geekman7473/enee408i-s2020-team2/ALAN_Carrier_board/carrier_board.brd

## EAGLE design ALAN_Carrier_board/carrier_board.brd (2020-02-28)

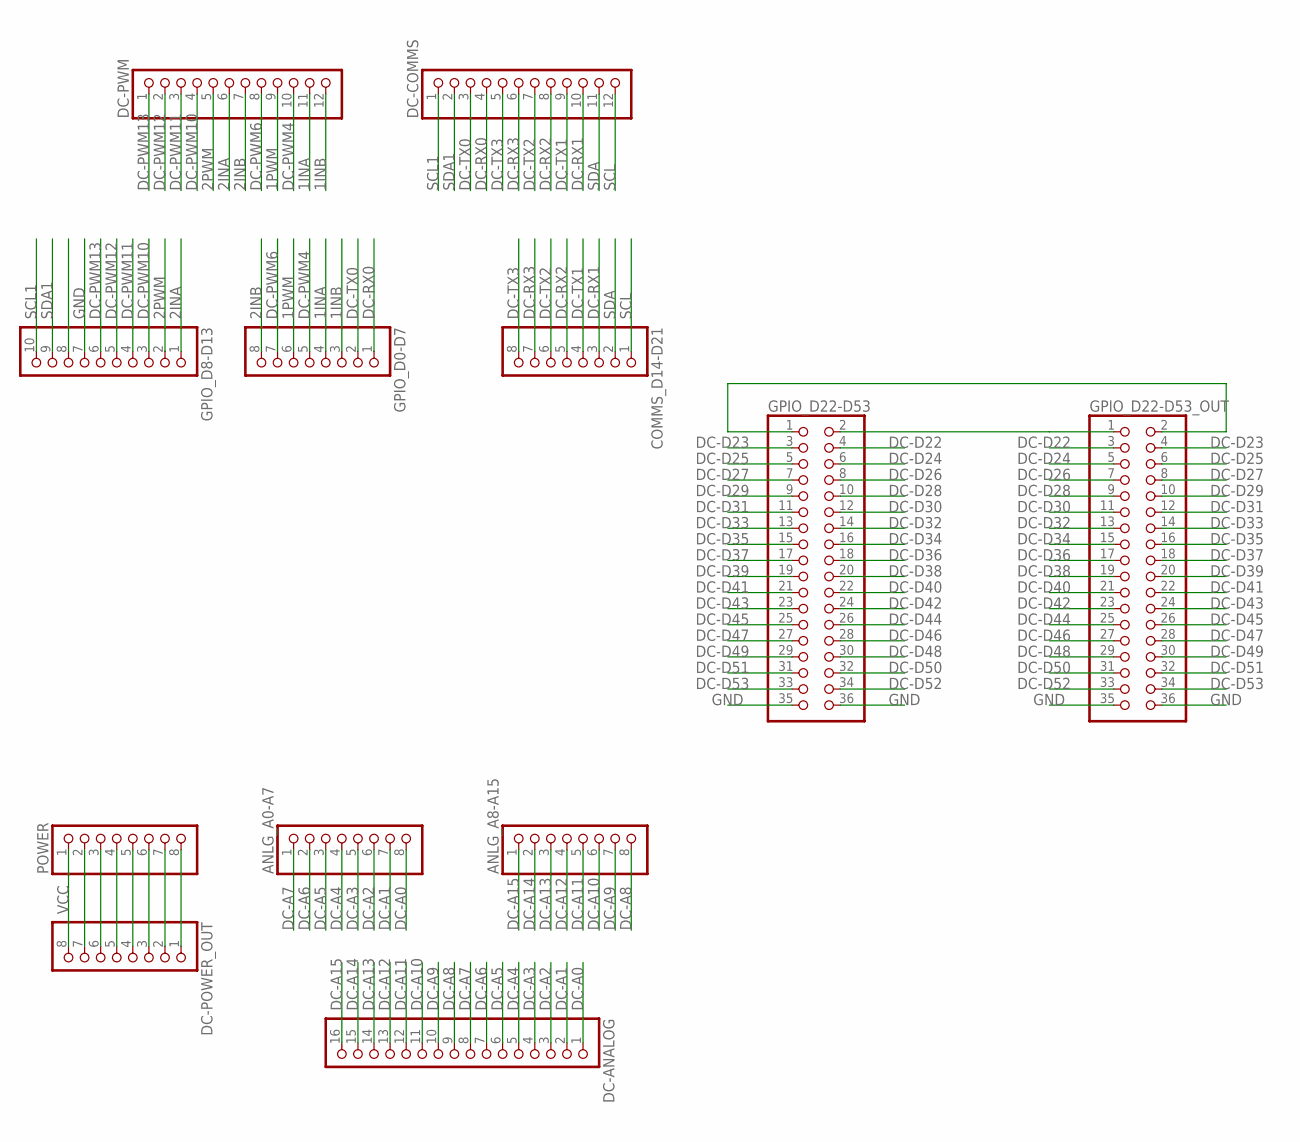
[picture p1: schematic carrier_board.sch, sheet 1, Main Board]

Parts:
ANLG_A0-A7, ANLG_A8-A15: PINHD-1X8; 1X08
COMMS_D14-D21: PINHD-1X8; 1X08
DC-ANALOG: PINHD-1X16; 1X16
DC-COMMS: PINHD-1X12; 1X12
DC-POWER_OUT: PINHD-1X8; 1X08
DC-PWM: PINHD-1X12; 1X12
GPIO_D0-D7: PINHD-1X8; 1X08
GPIO_D8-D13: PINHD-1X10; 1X10
GPIO_D22-D53, GPIO_D22-D53_OUT: PINHD-2X18; 2X18
POWER: PINHD-1X8; 1X08

Connections:
1INA: DC-PWM.11, GPIO_D0-D7.4; also elsewhere on the board
1INB: DC-PWM.12, GPIO_D0-D7.3; also elsewhere on the board
1PWM: DC-PWM.9, GPIO_D0-D7.6; also elsewhere on the board
2INA: DC-PWM.6, GPIO_D8-D13.1; also elsewhere on the board
2INB: DC-PWM.7, GPIO_D0-D7.8; also elsewhere on the board
2PWM: DC-PWM.5, GPIO_D8-D13.2; also elsewhere on the board
DC-A0: ANLG_A0-A7.8, DC-ANALOG.1
DC-A1: ANLG_A0-A7.7, DC-ANALOG.2
DC-A2: ANLG_A0-A7.6, DC-ANALOG.3
DC-A3: ANLG_A0-A7.5, DC-ANALOG.4
DC-A4: ANLG_A0-A7.4, DC-ANALOG.5
DC-A5: ANLG_A0-A7.3, DC-ANALOG.6
DC-A6: ANLG_A0-A7.2, DC-ANALOG.7
DC-A7: ANLG_A0-A7.1, DC-ANALOG.8
DC-A8: ANLG_A8-A15.8, DC-ANALOG.9
DC-A9: ANLG_A8-A15.7, DC-ANALOG.10
DC-A10: ANLG_A8-A15.6, DC-ANALOG.11
DC-A11: ANLG_A8-A15.5, DC-ANALOG.12
DC-A12: ANLG_A8-A15.4, DC-ANALOG.13
DC-A13: ANLG_A8-A15.3, DC-ANALOG.14
DC-A14: ANLG_A8-A15.2, DC-ANALOG.15
DC-A15: ANLG_A8-A15.1, DC-ANALOG.16
DC-D22: GPIO_D22-D53.4, GPIO_D22-D53_OUT.3
DC-D23: GPIO_D22-D53.3, GPIO_D22-D53_OUT.4
DC-D24: GPIO_D22-D53.6, GPIO_D22-D53_OUT.5
DC-D25: GPIO_D22-D53.5, GPIO_D22-D53_OUT.6
DC-D26: GPIO_D22-D53.8, GPIO_D22-D53_OUT.7
DC-D27: GPIO_D22-D53.7, GPIO_D22-D53_OUT.8
DC-D28: GPIO_D22-D53.10, GPIO_D22-D53_OUT.9
DC-D29: GPIO_D22-D53.9, GPIO_D22-D53_OUT.10
DC-D30: GPIO_D22-D53.12, GPIO_D22-D53_OUT.11
DC-D31: GPIO_D22-D53.11, GPIO_D22-D53_OUT.12
DC-D32: GPIO_D22-D53.14, GPIO_D22-D53_OUT.13
DC-D33: GPIO_D22-D53.13, GPIO_D22-D53_OUT.14
DC-D34: GPIO_D22-D53.16, GPIO_D22-D53_OUT.15
DC-D35: GPIO_D22-D53.15, GPIO_D22-D53_OUT.16
DC-D36: GPIO_D22-D53.18, GPIO_D22-D53_OUT.17
DC-D37: GPIO_D22-D53.17, GPIO_D22-D53_OUT.18
DC-D38: GPIO_D22-D53.20, GPIO_D22-D53_OUT.19
DC-D39: GPIO_D22-D53.19, GPIO_D22-D53_OUT.20
DC-D40: GPIO_D22-D53.22, GPIO_D22-D53_OUT.21
DC-D41: GPIO_D22-D53.21, GPIO_D22-D53_OUT.22
DC-D42: GPIO_D22-D53.24, GPIO_D22-D53_OUT.23
DC-D43: GPIO_D22-D53.23, GPIO_D22-D53_OUT.24
DC-D44: GPIO_D22-D53.26, GPIO_D22-D53_OUT.25
DC-D45: GPIO_D22-D53.25, GPIO_D22-D53_OUT.26
DC-D46: GPIO_D22-D53.28, GPIO_D22-D53_OUT.27
DC-D47: GPIO_D22-D53.27, GPIO_D22-D53_OUT.28
DC-D48: GPIO_D22-D53.30, GPIO_D22-D53_OUT.29
DC-D49: GPIO_D22-D53.29, GPIO_D22-D53_OUT.30
DC-D50: GPIO_D22-D53.32, GPIO_D22-D53_OUT.31
DC-D51: GPIO_D22-D53.31, GPIO_D22-D53_OUT.32
DC-D52: GPIO_D22-D53.34, GPIO_D22-D53_OUT.33
DC-D53: GPIO_D22-D53.33, GPIO_D22-D53_OUT.34
DC-PWM4: DC-PWM.10, GPIO_D0-D7.5
DC-PWM6: DC-PWM.8, GPIO_D0-D7.7
DC-PWM10: DC-PWM.4, GPIO_D8-D13.3
DC-PWM11: DC-PWM.3, GPIO_D8-D13.4
DC-PWM12: DC-PWM.2, GPIO_D8-D13.5
DC-PWM13: DC-PWM.1, GPIO_D8-D13.6
DC-RX0: DC-COMMS.4, GPIO_D0-D7.1
DC-RX1: COMMS_D14-D21.3, DC-COMMS.10
DC-RX2: COMMS_D14-D21.5, DC-COMMS.8
DC-RX3: COMMS_D14-D21.7, DC-COMMS.6
DC-TX0: DC-COMMS.3, GPIO_D0-D7.2
DC-TX1: COMMS_D14-D21.4, DC-COMMS.9
DC-TX2: COMMS_D14-D21.6, DC-COMMS.7
DC-TX3: COMMS_D14-D21.8, DC-COMMS.5
GND: GPIO_D8-D13.7, GPIO_D22-D53.35, GPIO_D22-D53.36, GPIO_D22-D53_OUT.35, GPIO_D22-D53_OUT.36; also elsewhere on the board
unnamed: GPIO_D22-D53.1, GPIO_D22-D53_OUT.2
unnamed: GPIO_D22-D53.2, GPIO_D22-D53_OUT.1
unnamed: DC-POWER_OUT.1, POWER.8
unnamed: DC-POWER_OUT.2, POWER.7
unnamed: DC-POWER_OUT.3, POWER.6
unnamed: DC-POWER_OUT.4, POWER.5
unnamed: DC-POWER_OUT.5, POWER.4
unnamed: DC-POWER_OUT.6, POWER.3
unnamed: DC-POWER_OUT.7, POWER.2
SCL: COMMS_D14-D21.1, DC-COMMS.12; also elsewhere on the board
SCL1: DC-COMMS.1, GPIO_D8-D13.10
SDA: COMMS_D14-D21.2, DC-COMMS.11; also elsewhere on the board
SDA1: DC-COMMS.2, GPIO_D8-D13.9
VCC: DC-POWER_OUT.8, POWER.1; also elsewhere on the board

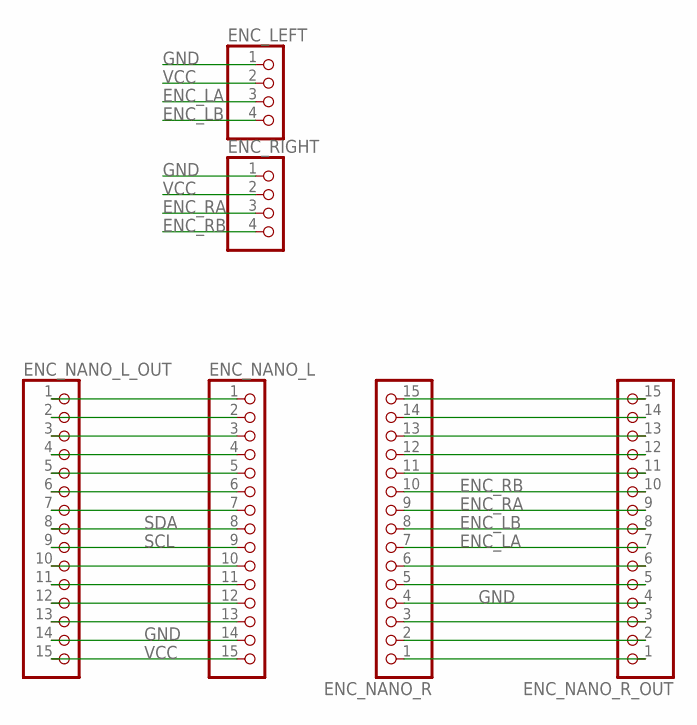
[picture p2: schematic carrier_board.sch, sheet 2, Encoder Nano]

Parts:
ENC_LEFT: PINHD-1X4/90; 1X04/90
ENC_NANO_L: PINHD-1X15; 1X15
ENC_NANO_L_OUT: PINHD-1X15; 1X15
ENC_NANO_R: PINHD-1X15; 1X15
ENC_NANO_R_OUT: PINHD-1X15; 1X15
ENC_RIGHT: PINHD-1X4/90; 1X04/90

Connections:
ENC_LA: ENC_LEFT.3, ENC_NANO_R.7, ENC_NANO_R_OUT.7
ENC_LB: ENC_LEFT.4, ENC_NANO_R.8, ENC_NANO_R_OUT.8
ENC_RA: ENC_NANO_R.9, ENC_NANO_R_OUT.9, ENC_RIGHT.3
ENC_RB: ENC_NANO_R.10, ENC_NANO_R_OUT.10, ENC_RIGHT.4
GND: ENC_LEFT.1, ENC_NANO_L.14, ENC_NANO_L_OUT.14, ENC_NANO_R.4, ENC_NANO_R_OUT.4, ENC_RIGHT.1; also elsewhere on the board
unnamed: ENC_NANO_L.13, ENC_NANO_L_OUT.13
unnamed: ENC_NANO_L.12, ENC_NANO_L_OUT.12
unnamed: ENC_NANO_L.11, ENC_NANO_L_OUT.11
unnamed: ENC_NANO_L.10, ENC_NANO_L_OUT.10
unnamed: ENC_NANO_L.7, ENC_NANO_L_OUT.7
unnamed: ENC_NANO_L.6, ENC_NANO_L_OUT.6
unnamed: ENC_NANO_L.5, ENC_NANO_L_OUT.5
unnamed: ENC_NANO_L.4, ENC_NANO_L_OUT.4
unnamed: ENC_NANO_L.3, ENC_NANO_L_OUT.3
unnamed: ENC_NANO_L.2, ENC_NANO_L_OUT.2
unnamed: ENC_NANO_L.1, ENC_NANO_L_OUT.1
unnamed: ENC_NANO_R.15, ENC_NANO_R_OUT.15
unnamed: ENC_NANO_R.14, ENC_NANO_R_OUT.14
unnamed: ENC_NANO_R.13, ENC_NANO_R_OUT.13
unnamed: ENC_NANO_R.12, ENC_NANO_R_OUT.12
unnamed: ENC_NANO_R.11, ENC_NANO_R_OUT.11
unnamed: ENC_NANO_R.6, ENC_NANO_R_OUT.6
unnamed: ENC_NANO_R.5, ENC_NANO_R_OUT.5
unnamed: ENC_NANO_R.3, ENC_NANO_R_OUT.3
unnamed: ENC_NANO_R.2, ENC_NANO_R_OUT.2
unnamed: ENC_NANO_R.1, ENC_NANO_R_OUT.1
SCL: ENC_NANO_L.9, ENC_NANO_L_OUT.9; also elsewhere on the board
SDA: ENC_NANO_L.8, ENC_NANO_L_OUT.8; also elsewhere on the board
VCC: ENC_LEFT.2, ENC_NANO_L.15, ENC_NANO_L_OUT.15, ENC_RIGHT.2; also elsewhere on the board

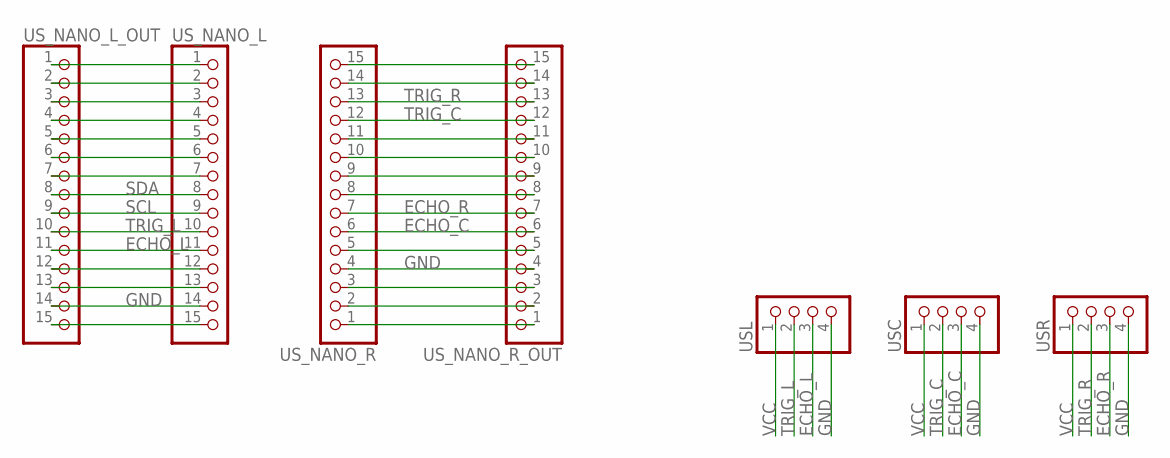
[picture p3: schematic carrier_board.sch, sheet 3, Ultrasonic Nano]

Parts:
USC: PINHD-1X4/90; 1X04/90
USL: PINHD-1X4/90; 1X04/90
USR: PINHD-1X4/90; 1X04/90
US_NANO_L: PINHD-1X15; 1X15
US_NANO_L_OUT: PINHD-1X15; 1X15
US_NANO_R: PINHD-1X15; 1X15
US_NANO_R_OUT: PINHD-1X15; 1X15

Connections:
ECHO_C: USC.3, US_NANO_R.6, US_NANO_R_OUT.6
ECHO_L: USL.3, US_NANO_L.11, US_NANO_L_OUT.11
ECHO_R: USR.3, US_NANO_R.7, US_NANO_R_OUT.7
GND: USC.4, USL.4, USR.4, US_NANO_L.14, US_NANO_L_OUT.14, US_NANO_R.4, US_NANO_R_OUT.4; also elsewhere on the board
unnamed: US_NANO_R.15, US_NANO_R_OUT.15
unnamed: US_NANO_R.14, US_NANO_R_OUT.14
unnamed: US_NANO_R.11, US_NANO_R_OUT.11
unnamed: US_NANO_R.10, US_NANO_R_OUT.10
unnamed: US_NANO_R.9, US_NANO_R_OUT.9
unnamed: US_NANO_R.8, US_NANO_R_OUT.8
unnamed: US_NANO_R.5, US_NANO_R_OUT.5
unnamed: US_NANO_R.3, US_NANO_R_OUT.3
unnamed: US_NANO_R.2, US_NANO_R_OUT.2
unnamed: US_NANO_R.1, US_NANO_R_OUT.1
unnamed: US_NANO_L.1, US_NANO_L_OUT.1
unnamed: US_NANO_L.2, US_NANO_L_OUT.2
unnamed: US_NANO_L.3, US_NANO_L_OUT.3
unnamed: US_NANO_L.4, US_NANO_L_OUT.4
unnamed: US_NANO_L.5, US_NANO_L_OUT.5
unnamed: US_NANO_L.6, US_NANO_L_OUT.6
unnamed: US_NANO_L.7, US_NANO_L_OUT.7
unnamed: US_NANO_L.12, US_NANO_L_OUT.12
unnamed: US_NANO_L.13, US_NANO_L_OUT.13
SCL: US_NANO_L.9, US_NANO_L_OUT.9; also elsewhere on the board
SDA: US_NANO_L.8, US_NANO_L_OUT.8; also elsewhere on the board
TRIG_C: USC.2, US_NANO_R.12, US_NANO_R_OUT.12
TRIG_L: USL.2, US_NANO_L.10, US_NANO_L_OUT.10
TRIG_R: USR.2, US_NANO_R.13, US_NANO_R_OUT.13
VCC: USC.1, USL.1, USR.1; also elsewhere on the board
VCC1: US_NANO_L.15, US_NANO_L_OUT.15

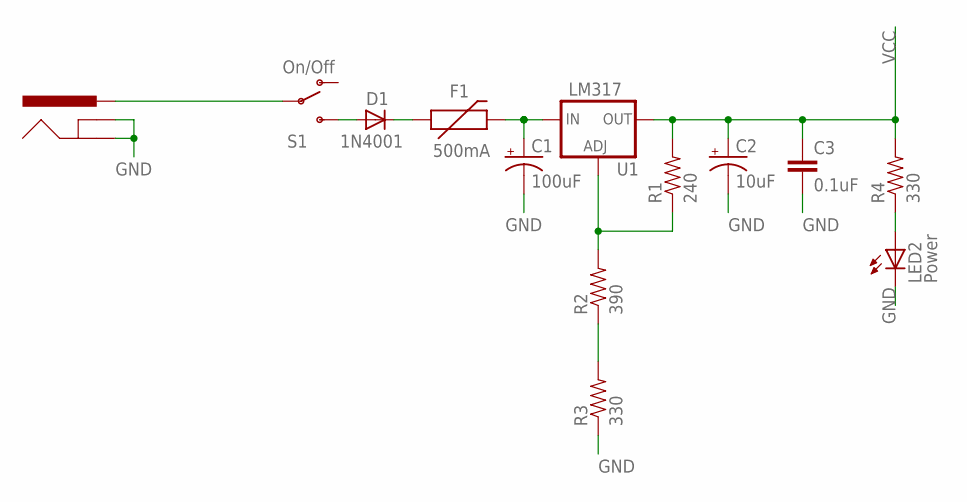
[picture p4: schematic carrier_board.sch, sheet 4, 5v Power board TODO: Remove 3.3 switch]

Parts:
C1: 100uF; CPOL-RADIAL-100UF-25V
C2: 10uF; CPOL-RADIAL-10UF-25V
C3: 0.1uF; CAP-PTH-SMALL2
D1: 1N4001; DIODE-0.4
F1: 500mA; PTC
J1: POWER_JACKPTH; POWER_JACK_PTH
LED2: Power; LED5MM
R1: 240; AXIAL-0.3
R2: 390; AXIAL-0.3
R3, R4: 330; AXIAL-0.3
S1: On/Off; SWITCH-SPST
U1: LM317; TO220-ADJ

Connections:
GND: C1.2 (-), C2.2 (-), C3.2, J1.GND, J1.GNDBREAK, LED2.K (C), R3.P$1 (1); also elsewhere on the board
unnamed: D1.C, F1.P$1 (1)
unnamed: D1.A, S1.3 (S)
unnamed: J1.PWR, S1.2
unnamed: R2.P$1 (1), R3.P$2 (2)
unnamed: R1.P$1 (1), R2.P$2 (2), U1.ADJ
unnamed: LED2.A, R4.P$1 (1)
RAW: C1.1 (+), F1.P$2 (2), U1.IN
VCC: C2.1 (+), C3.1, R1.P$2 (2), R4.P$2 (2), U1.OUT; also elsewhere on the board

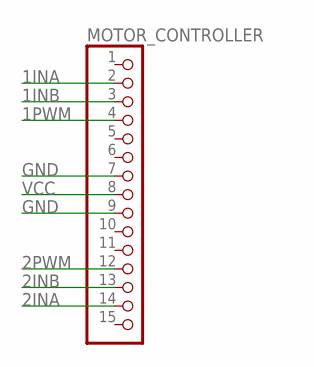
[picture p5: schematic carrier_board.sch, sheet 5, Motors/Motor Controllers]

Parts:
MOTOR_CONTROLLER: PINHD-1X15; 1X15

Connections:
1INA: MOTOR_CONTROLLER.2; also elsewhere on the board
1INB: MOTOR_CONTROLLER.3; also elsewhere on the board
1PWM: MOTOR_CONTROLLER.4; also elsewhere on the board
2INA: MOTOR_CONTROLLER.14; also elsewhere on the board
2INB: MOTOR_CONTROLLER.13; also elsewhere on the board
2PWM: MOTOR_CONTROLLER.12; also elsewhere on the board
GND: MOTOR_CONTROLLER.7, MOTOR_CONTROLLER.9; also elsewhere on the board
VCC: MOTOR_CONTROLLER.8; also elsewhere on the board

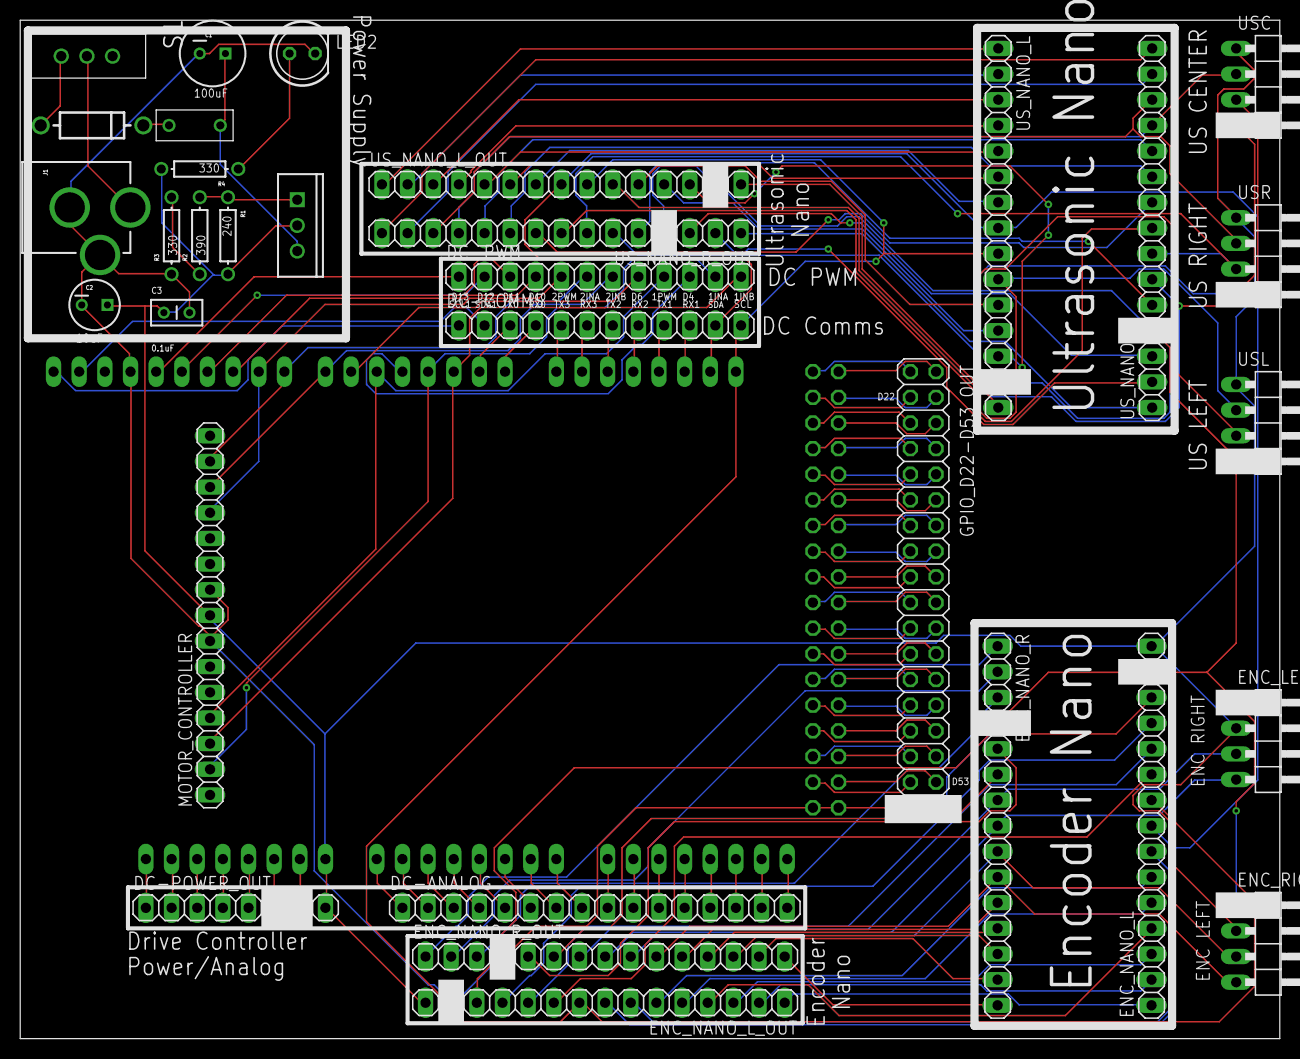
[picture p6: board carrier_board.brd from above]

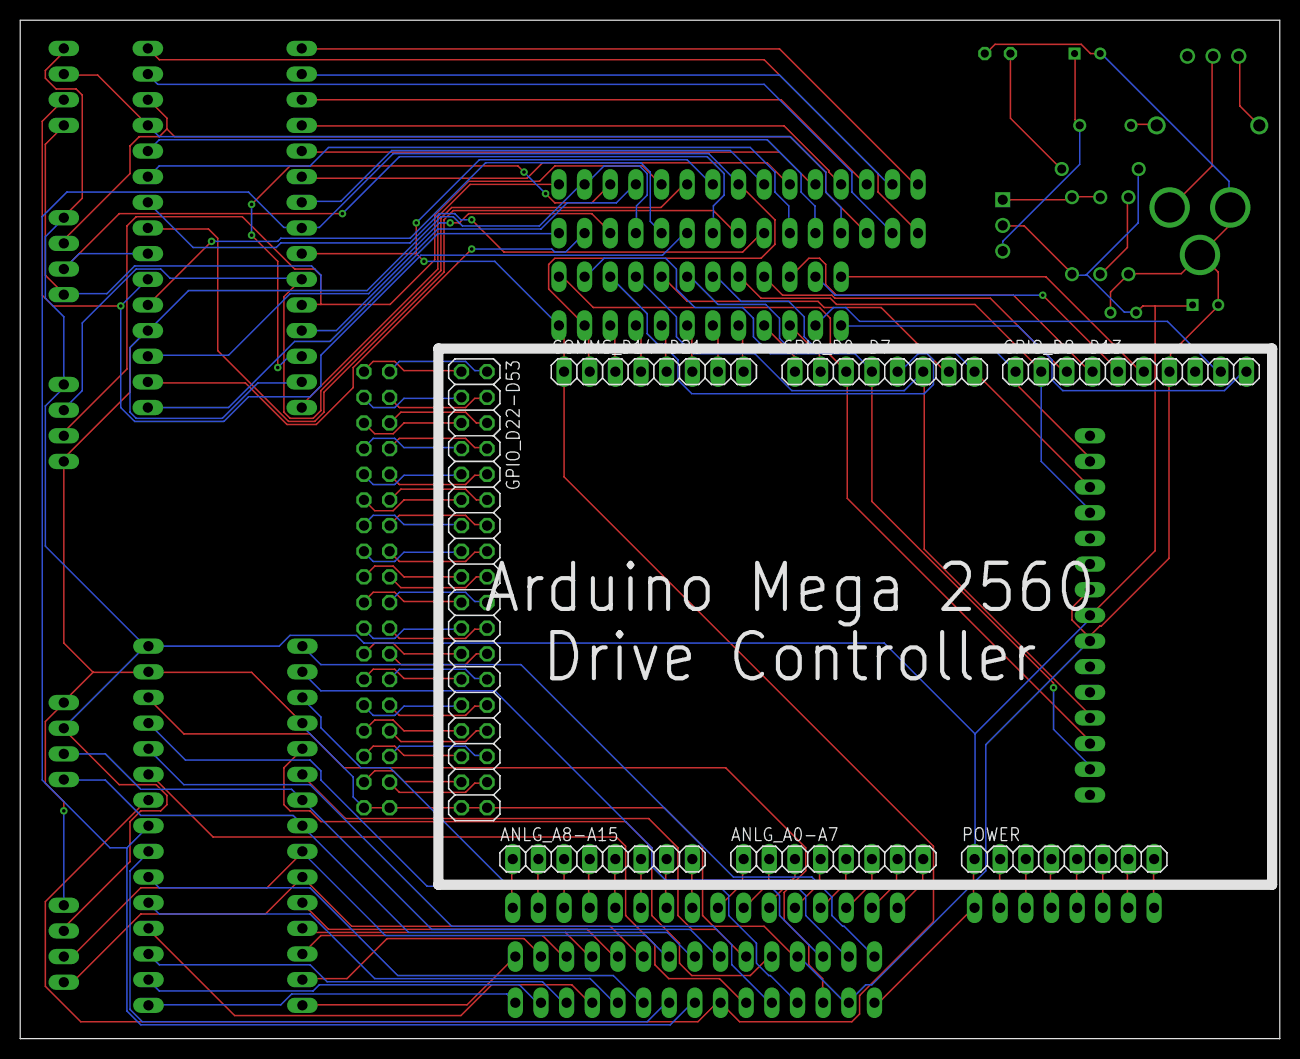
[picture p7: board carrier_board.brd from below]

Board: 2 copper layers, 124.7 x 100.8 mm, 39 parts (7 on the bottom side), 141 nets.
