geekman7473/enee408i-s2020-team2/(threads)

Thread 2 (2020-02-13):

Add Support for Ultrasonics

apozharski, 2020-02-13:
Add Ultrasonic support, with the following key features:
- Non-blocking
- Able to interrupt command state to avoid collision
- Send to jetson an alert when doing taking evasive maneuvers.

Possibly useful features:
- Query-able from the Jetson

apozharski, 2020-02-17:
Moving this to co-processor per IRL with @geekman7473 and @syan6812

geekman7473, 2020-02-25:
co-processor work complete. beginning work on basic collision avoidance.

Thread 5 (2020-02-17):

Camera mount design.

apozharski, 2020-02-17:
Camera's used for SLAM and triangulation of targets need stable well defined mounts in order to provide consistent results. We need to design a (3d printed?) mount for the bottom stereo camera system.
