geekman7473/enee408i-s2020-team2/(commit log)

2020-01-31 splitting arduino sketches
2020-02-02 Workingish print to serial
2020-02-02 Added encoder library
2020-02-02 Moved encoder library files
2020-02-02 working timer
2020-02-02 Encoder now work
2020-02-02 Updated encoder processor to handle two encoders at once
2020-02-02 Added PID to drive_controller
2020-02-03 Working timer interrupt. TODO: calculate frequency and speed calculations
2020-02-04 Working i2c communication. Still missing speed calculations
    [drive_controller.ino, encoder_processor.ino]
2020-02-04 fliped motors
2020-02-13 Added serial control and PID in loop. TODO cleanup code quality
2020-02-17 Added ultrasonic code using interupts
2020-02-28 Add unreviewed board
    [carrier_board.brd, carrier_board.sch]
2020-02-28 Gitignore and latest files
    [carrier_board.brd, carrier_board.sch]
